mronchka/KeiserMagBridge/bench/diagrams/m3_overview.png

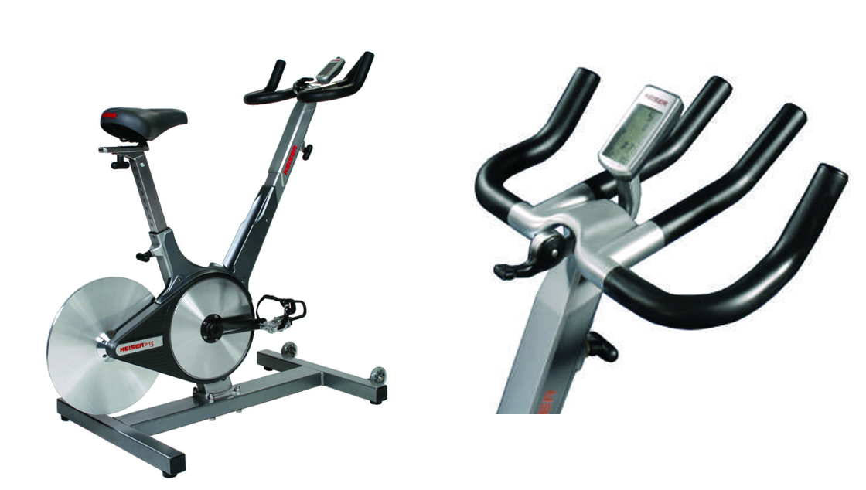
bench/diagrams/m3_overview.png
