mronchka/KeiserMagBridge/bench/diagrams/m3_belt_covers.png

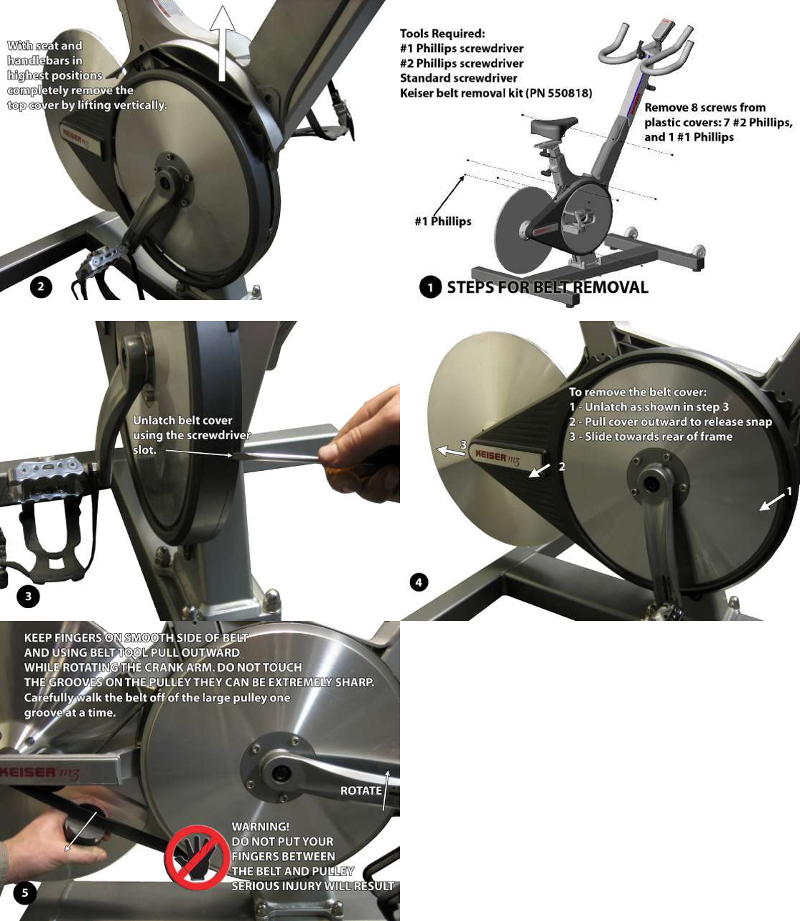
bench/diagrams/m3_belt_covers.png
