mronchka/KeiserMagBridge/bench/diagrams/m3_circuit_board.png

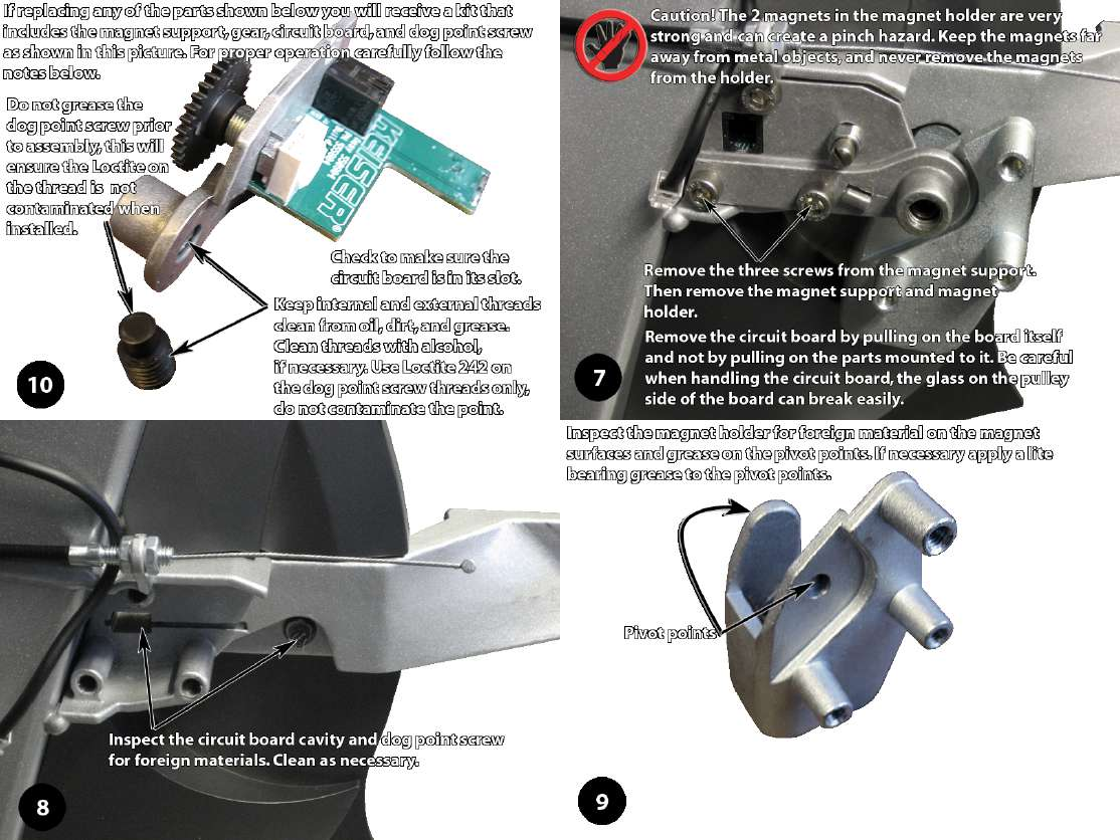
bench/diagrams/m3_circuit_board.png
