mronchka/KeiserMagBridge/bench/diagrams/m3_resistance_mechanism.png

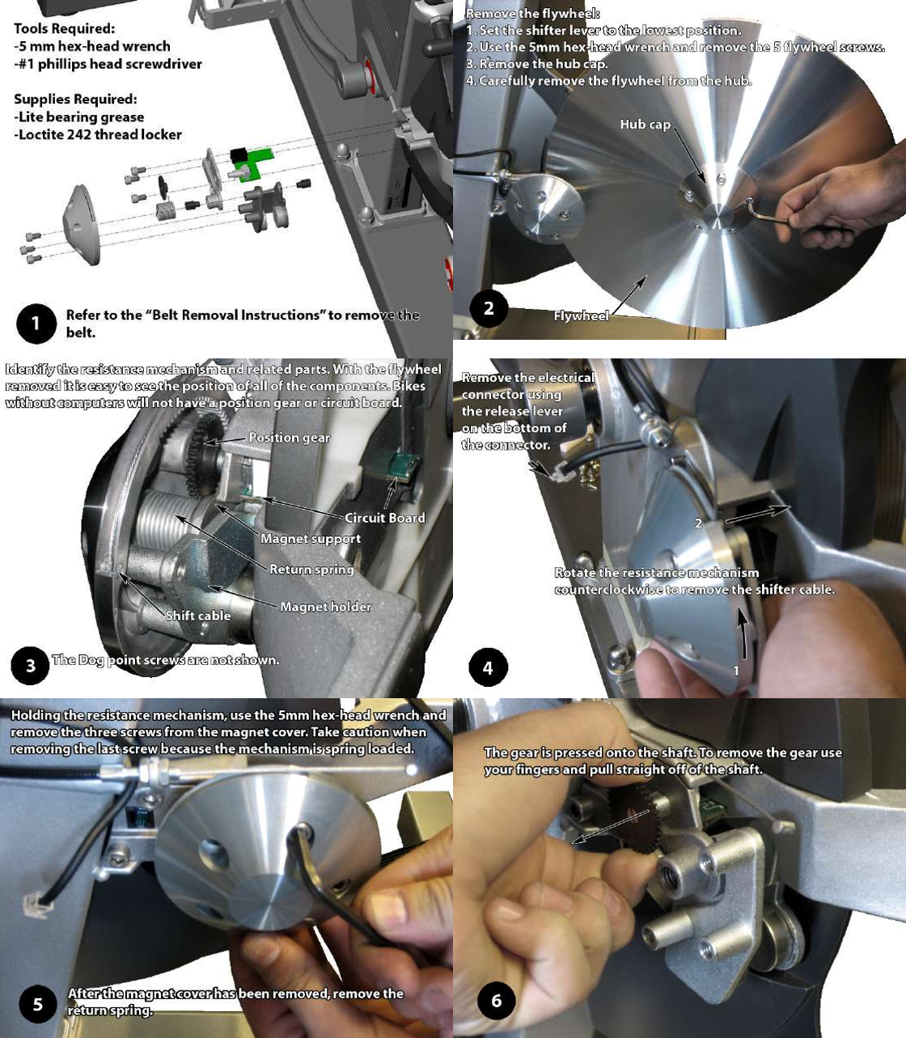
bench/diagrams/m3_resistance_mechanism.png
