mronchka/KeiserMagBridge/bench/results/method_bench_2026-10-15_cadence_test.csv

method | label | condition | sd_ped | p2p_ped | bias_abs_med | bias_abs_max | sd_easy | sd_fast | sd_still | resolution | steps_resolved | steps_total | delay_med | stopped_bias
sketch_now | Sketch v1/v2 smoothing (130 ms) | clean | 13.7015 | 42.8455 | 0.4077 | 1.7890 | 18.1336 | 12.5512 | 0.1466 | 54.8059 | 0 | 10 | nan | -11.4140
sketch_now | Sketch v1/v2 smoothing (130 ms) | stalls | 10.1722 | 35.8780 | 1.2186 | 2.1905 | 15.5400 | 9.5736 | 0.1146 | 40.6887 | 0 | 10 | nan | -11.3719
ema_1s | Plain smoothing | 1 s | clean | 2.7279 | 7.2634 | 0.1818 | 0.4498 | 5.0111 | 2.2877 | 0.0767 | 10.9118 | 3 | 10 | 5.5599 | -11.0223
ema_1s | Plain smoothing | 1 s | stalls | 3.2542 | 10.3956 | 0.5440 | 1.0914 | 5.0923 | 3.0219 | 0.0761 | 13.0169 | 3 | 10 | 6.3399 | -11.0034
ema_2s | Plain smoothing | 2 s | clean | 1.3767 | 3.7537 | 0.3100 | 2.1744 | 2.5598 | 1.1454 | 0.2131 | 5.5068 | 7 | 10 | 5.4539 | -10.3038
ema_2s | Plain smoothing | 2 s | stalls | 1.6851 | 5.1662 | 0.4520 | 2.1189 | 2.6009 | 1.6225 | 0.1788 | 6.7403 | 5 | 10 | 6.2959 | -10.2412
box_2s | Moving average | 2 s | clean | 2.3069 | 6.6042 | 0.1789 | 0.4606 | 3.3218 | 1.6501 | 0.0829 | 9.2275 | 3 | 10 | 5.4989 | -10.9611
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
