mronchka/KeiserMagBridge/bench/logs/2026-10-15_cadence_test_turns.csv

t_epoch_s | lever_uT_turn_avg | rpm
1792114582.470 | -126.38 | 75.1
1792114583.280 | -126.73 | 73.1
1792114584.081 | -126.31 | 76.9
1792114584.850 | -126.30 | 79.1
1792114585.629 | -126.08 | 75.1
1792114586.439 | -126.60 | 73.1
1792114587.229 | -125.21 | 79.1
1792114587.987 | -115.78 | 79.2
1792114588.746 | -105.32 | 79.1
1792114589.494 | -103.80 | 81.3
1792114590.233 | -103.80 | 81.2
1792114590.981 | -104.14 | 79.2
1792114591.750 | -104.53 | 76.9
1792114592.530 | -103.32 | 77.0
1792114593.319 | -103.71 | 75.0
1792114594.130 | -104.30 | 73.1
1792114594.930 | -93.94 | 77.0
1792114595.710 | -91.63 | 76.8
1792114596.490 | -90.75 | 76.9
1792114597.280 | -91.05 | 75.0
1792114598.080 | -80.17 | 75.0
1792114598.890 | -79.30 | 73.2
1792114599.711 | -78.60 | 73.1
1792114600.542 | -78.29 | 71.3
1792114601.393 | -79.02 | 69.7
1792114602.234 | -77.23 | 73.1
1792114603.075 | -76.13 | 69.6
1792114603.916 | -74.81 | 73.3
1792114604.746 | -75.20 | 71.3
1792114605.586 | -74.84 | 71.4
1792114606.407 | -73.65 | 74.9
1792114607.208 | -74.71 | 74.9
1792114608.007 | -74.35 | 75.1
1792114608.807 | -73.47 | 75.0
1792114609.617 | -73.68 | 73.2
1792114610.437 | -73.07 | 73.1
1792114611.268 | -73.98 | 71.3
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
