mronchka/KeiserMagBridge/bench/tests/test_v33_sim.py

"""Tier B (bench/V3_3_PLAN.md section 6): closed-loop simulated riders on fw_model.

Usage: py -3 bench/tests/test_v33_sim.py [--only B1,B3] [--quick] [--save-scenarios]

The riders (riders.py) behave like the real bike on 2026-10-16: the lever
settles back after stopping, sometimes creeps, wobbles turn to turn
(median 0.5 uT between turns), cadence drops from ~75 to ~45 rpm in the high
gears.  Scenarios B1-B12 follow the plan.  On the v3.2 model, scenarios that
need a v3.3 feature are SKIPped with the missing name; checks that the v3.2
model fails here are the v3.2 problems v3.3 is meant to fix (issues #2-#4).

--save-scenarios writes B1, B5 and B12 runs to bench/tests/scenarios/*.json
for hil_replay.py (open-loop replay on the board).
Exit code 1 if a check fails.
"""
import math
import os
import statistics as st
import sys

sys.path.insert(0, os.path.dirname(os.path.abspath(__file__)))
import fw_model as fw  # noqa: E402
import riders as R  # noqa: E402
from riders import API, UP_EDGE  # noqa: E402

HERE = os.path.dirname(os.path.abspath(__file__))
ARGS = sys.argv[1:]
QUICK = "--quick" in ARGS
SAVE = "--save-scenarios" in ARGS
ONLY = None
if "--only" in ARGS:
    ONLY = set(ARGS[ARGS.index("--only") + 1].upper().split(","))
SEEDS = (1,) if QUICK else (1, 2)
ck = R.Checker("test_v33_sim")
V33 = API.is_v33()
print(f"Model: {API.version()} ({'v3.3 API found' if V33 else 'no derive_tolerances: v3.2 model, v3.3-only checks skip'})")


def want(name):
    return ONLY is None or name in ONLY


def need(feature, ok):
    if not ok:
        ck.skip(f"needs the v3.3 model: {feature}")
    return ok


def summary(r):
    e = r.errors()
    eh = max((x["err_hold"] for x in e), default=0)
    return (f"{r.label}: {r.sim.t():.0f} s, {len(r.ups())} up + {len(r.downs())} down, "
            f"in order {r.in_order()}, {r.f_end()} {r.flags() or ''}, N,behind {r.count('N,behind')}, "
            f"go-backs {r.gobacks()} (+{r.gobacks(False) - r.gobacks()} after N,stuck), N,stuck {r.count('N,stuck')}, rider undos {r.rider.undos}, W {r.count('W,')}, P {r.count('P,')}, worst hold error {eh:.2f} uT")


def survey_ok(r):
    z = [l for l in r.lines if l.startswith("Z,")]
    return z


def complete(r, tag, n_down=22):
    ck.check(r.saved() and len(r.ups()) == 24 and len(r.downs()) == n_down,
             f"{tag}: saved, 24 up + {n_down} down points ({len(r.ups())} + {len(r.downs())})")


def accurate(r, tag, lim=None, unit=1.0):
    """lim given: every point within lim (wobble-free riders).  Otherwise the realistic lever's
    statistics: median <= 0.35, 90th percentile <= 0.8, worst <= 1.3 uT (x unit).  A 3-turn average of
    the bike's wobble is off by 0.19 uT typically and 0.91 uT at the 90th percentile (NOTES.md)."""
    e = sorted(x["err_hold"] for x in r.errors())
    if not e:
        return ck.check(False, f"{tag}: no points")
    if lim is not None:
        bad = [(x["key"], round(x["err_hold"], 2)) for x in r.errors() if x["err_hold"] > lim * unit]
        return ck.check(not bad, f"{tag}: every point within {lim * unit:.2f} uT of where the lever rested {bad[:6] if bad else ''}")
    med, p90, mx = e[len(e) // 2], e[int(0.9 * (len(e) - 1))], e[-1]
    ck.check(med <= 0.35 * unit and p90 <= 0.8 * unit and mx <= 1.3 * unit,
             f"{tag}: points vs where the lever rested: median {med:.2f}, p90 {p90:.2f}, worst {mx:.2f} uT "
             f"(limits {0.35 * unit:.2f} / {0.8 * unit:.2f} / {1.3 * unit:.2f})")


def step_len(key):
    """The console step this point is reached by (uT along the lever, scale 1)."""
    i = key if isinstance(key, int) else key[1]
    if isinstance(key, int):
        return UP_EDGE[i] - UP_EDGE[i - 1] if i > 0 else 99.0
    return UP_EDGE[i + 1] - UP_EDGE[i] if i < 23 else 99.0


def early_save(x):
    """Saved well short of where the rider meant to stop (more than 40 % of the step, and 1.5 uT)."""
    return x["err_stop"] is not None and x["err_stop"] > max(1.5, 0.4 * step_len(x["key"]))


def steps_seen(r):
    return getattr(r, "steps", [])


def run(label, **kw):
    """run_cal plus a step-number trace."""
    steps = []
    rk = kw.pop("rider_kw", {}) or {}
    r = R.run_cal(label=label, rider_kw=rk, **kw)
    return r


# ================================================================== B1
if want("B1"):
    print("\nB1. Normal rider at 3 cadences: 46 points in order, accurate, no go-backs, no flags")
    for rpm in (55, 90):
        r = run(f"B1a {rpm} rpm, no wobble", seed=5, rpm=rpm, sim_kw=dict(wobble=0.0))
        print("   " + summary(r))
        complete(r, f"B1a {rpm} rpm")
        accurate(r, f"B1a {rpm} rpm (lever without wobble)", lim=0.6)
        ck.check(r.gobacks() == 0 and r.rider.undos == 0 and r.in_order(), f"B1a {rpm} rpm: in order, no go-back")
    flags_total, runs = 0, 0
    for rpm in (55, 75, 90):
        for seed in SEEDS:
            r = run(f"B1 {rpm} rpm seed {seed}", seed=seed, rpm=rpm, sim_kw=dict(record=SAVE and seed == 1 and rpm == 75))
            print("   " + summary(r))
            tag = f"B1 {rpm} rpm s{seed}"
            complete(r, tag)
            ck.check(r.in_order(), f"{tag}: both passes in lever order")
            accurate(r, tag)
            ck.check(r.gobacks() == 0 and r.rider.undos == 0, f"{tag}: no false go-back, never stuck (go-backs {r.gobacks()}, undos {r.rider.undos})")
            ck.check(r.count("P,") == 0, f"{tag}: no 'keeps changing' card")
            flags_total += len(r.flags())
            runs += 1
            if V33:
                z = survey_ok(r)
                ck.check(bool(z) and z[-1].split(",")[-1] == "ok", f"{tag}: survey ran, verdict ok ({z[-1] if z else 'no Z'})")
            if SAVE and seed == 1 and rpm == 75:
                R.save_scenario(r.sim.scenario("B1", "normal rider 75 rpm seed 1"), os.path.join(HERE, "scenarios", "B1.json"))
                print("   saved scenarios/B1.json")
    ck.check(flags_total / runs <= 0.2, f"B1: false flags per clean calibration {flags_total}/{runs} = {flags_total / runs:.2f} (<= 0.2)")

# ================================================================== B2
if want("B2"):
    print("\nB2. Slow shifter: 2.5 s before each move; nothing saved before the lever moved")
    for seed in SEEDS:
        r = run(f"B2 seed {seed}", seed=seed + 10, rider_kw=dict(react_s=2.5))
        print("   " + summary(r))
        early = [(x["key"], round(x["err_stop"], 1)) for x in r.errors() if early_save(x)]
        ck.check(not early, f"B2 s{seed}: no point saved before the lever got there {early[:6] if early else ''}")
        complete(r, f"B2 s{seed}")
        ck.check(r.gobacks() == 0 and r.rider.undos == 0,
                 f"B2 s{seed}: no false go-back (the lever settles while the rider waits; go-backs {r.gobacks()}, undos {r.rider.undos})")

# ================================================================== B3
if want("B3"):
    print("\nB3. Stop - shift - pedal at every gear (3-8 s stops): completes, no 'keeps changing', no buzzer")
    for seed in SEEDS:
        r = run(f"B3 seed {seed}", seed=seed + 20, rider_kw=dict(stop_shift=1.0, pause_s=(3.0, 8.0)), seconds=1500)
        print("   " + summary(r))
        complete(r, f"B3 s{seed}")
        ck.check(r.count("P,") == 0, f"B3 s{seed}: never the 'keeps changing' card (P lines: {r.count('P,')})")
        accurate(r, f"B3 s{seed}")
        beeps = getattr(r.f, "beeps", None)
        if beeps is not None:
            ck.check(not [b for b in beeps if b[1] in ("buzz", "warn", "alarm")], f"B3 s{seed}: no buzzer")
        else:
            ck.skip("B3: buzzer check needs Firmware.beeps (speaker events) in the model")

# ================================================================== B4
if want("B4"):
    print("\nB4. A 60 s rest in the up pass (point 12) and the down pass (down point 10): resumes, nothing lost")
    for seed in SEEDS:
        r = run(f"B4 seed {seed}", seed=seed + 30,
                rider_kw=dict(rests={(fw.PASS_UP, 11): 60.0, (fw.PASS_DOWN, 9): 60.0}), seconds=1500)
        print("   " + summary(r))
        complete(r, f"B4 s{seed}")
        # v3.4: no N,stuck hint, so in auto mode a gear that sits on the one before (here down 4 / 5, 0.5 uT
        # apart) can leave the rider waiting until they undo; press mode (test_v34_press.py) has none.
        ck.check(r.gobacks() == 0 and r.rider.undos <= 2 and r.count("A,") == 0,
                 f"B4 s{seed}: no go-back / abort around the rests, at most 2 undos ({r.gobacks()}, {r.rider.undos}, {r.count('A,')})")
        keys = [c[1] for c in r.f.captures]
        redone = {int(l.split(",")[1]) for l in r.lines if l.startswith("U,")}       # went back to it (U,<step>)
        twice = sorted({str(k) for k in keys if keys.count(k) > 1 and (k if isinstance(k, int) else k[1]) not in redone})
        ck.check(not twice, f"B4 s{seed}: no point captured twice without a go-back/undo {twice}")
        accurate(r, f"B4 s{seed}")
        ck.check(r.count("P,") == 0, f"B4 s{seed}: no 'keeps changing' card after the rest")

# ================================================================== B5
if want("B5"):
    print("\nB5. Overshoot on the up pass (point 10) and the down pass (down point 13): one go-back, redone at the edge")
    for ps, step, name in ((fw.PASS_UP, 9, "up point 10"), (fw.PASS_DOWN, 12, "down point 13")):
        r = run(f"B5 {name}", seed=41, rider_kw=dict(overshoot_at={(ps, step)}),
                sim_kw=dict(record=SAVE and ps == fw.PASS_UP))
        print("   " + summary(r))
        lc = r.last_caps()
        key = ('u', step) if ps == fw.PASS_UP else ('d', step)
        want_ = r.sim.stops.get((ps, step), float("nan"))             # where the rider came back to
        got = R.along(lc[key][1]) if key in lc else float("nan")
        ck.check(r.gobacks() == 1 and r.rider.undos == 0, f"B5 {name}: the board went back once by itself ({r.gobacks()}, undos {r.rider.undos})")
        ck.check(abs(got - want_) < 1.0 and r.in_order(), f"B5 {name}: redone where the rider came back to the edge "
                                                          f"({got:.1f} vs {want_:.1f}, within 1.0), in order")
        complete(r, f"B5 {name}")
        if SAVE and ps == fw.PASS_UP:
            R.save_scenario(r.sim.scenario("B5", "overshoot at up point 10, seed 41"), os.path.join(HERE, "scenarios", "B5.json"))
            print("   saved scenarios/B5.json")

    print("   B5b: a small overshoot (1.2 uT past the next edge, under the behind tolerance)")
    for ps, step, name in ((fw.PASS_UP, 9, "up point 10"), (fw.PASS_DOWN, 12, "down point 13")):
        r = run(f"B5b {name}", seed=42, rider_kw=dict(overshoot_at={(ps, step)}, overshoot_by=1.2))
        print("   " + summary(r))
        complete(r, f"B5b {name}")
        # the rider then stands at the next point, which is within must-move of the overshot one
        quiet = [x for x in r.rider.log if "undo" in x[1]]
        # v3.4: the N,stuck hint is gone (it misled the rider on the bike); a wait can end in one undo
        ck.check(len(quiet) <= 1, f"B5b {name}: at most one undo after the small overshoot (undos: {quiet[:2]})")
        flagged_ = {(p, n) for p, n, _ in r.flags()}
        ck.info(f"B5b {name}: go-backs {r.gobacks()}, N lines {r.count('N,')}, final flags {sorted(flagged_)}")

# ================================================================== B6
if want("B6"):
    print("\nB6. The lever settles back 0.1-0.8 uT (sometimes 1.2) after every save (the v3.2b behaviour): no go-backs")
    for seed in SEEDS:
        r = run(f"B6 seed {seed}", seed=seed + 60, sim_kw=dict(settle=(1.0, "save"), settle_big=0.15))
        print("   " + summary(r))
        ck.check(r.gobacks() == 0 and r.rider.undos == 0,
                 f"B6 s{seed}: zero go-backs (go-backs {r.gobacks()}, undos {r.rider.undos})")
        complete(r, f"B6 s{seed}")
        ck.check(len(r.flags()) <= 1, f"B6 s{seed}: at most 1 flag ({r.flags()})")

# ================================================================== B7
if want("B7"):
    print("\nB7. Pauses mid-gear (still pedalling) with a stored calibration at the same spot")
    for frac, hard in (((0.2, 0.35), True), ((0.45, 0.6), False)):
        for seed in SEEDS:
            cal = R.scaled_cal_at()
            r = run(f"B7 frac {frac} seed {seed}", seed=seed + 70, cal=cal,
                    rider_kw=dict(mid_pause=1.0, mid_s=(4.0, 6.0), mid_frac=frac), seconds=1500)
            print("   " + summary(r))
            mids = r.rider.mids
            saved_mid = []
            for x in r.errors():
                k = x["key"]
                sk = (fw.PASS_UP, k) if isinstance(k, int) else ((fw.PASS_DOWN, k[1]) if k[0] == 'd' else None)
                if sk in mids and abs(x["at"] - mids[sk][0]) < 1.0 and early_save(x):
                    saved_mid.append(sk)
            nm = lambda k: ("u" if k[0] == fw.PASS_UP else "d") + str(k[1] + 1)  # noqa: E731
            msg = (f"B7 pauses at {frac[0]:.2f}-{frac[1]:.2f} of the step, s{seed}: none saved mid-gear "
                   f"({len(saved_mid)} of {len(mids)} were: {' '.join(nm(k) for k in saved_mid[:12])})")
            if hard:
                ck.check(len(saved_mid) <= 10, msg + " (known limit: pass at <= 10)")
            else:
                ck.info(msg + " [spec: must-move = 0.4 x expected step, so pauses past 0.4 can't be told apart]")
            complete(r, f"B7 {frac} s{seed}")

# ================================================================== B8
if want("B8"):
    print("\nB8. Phone disconnect during the up pass (point 8, 20 s)")
    f0 = fw.Firmware()
    if need("Firmware.phone_connected()", hasattr(f0, "phone_connected")):
        for src, should_pause in (("ble", True), ("usb", False)):
            r = R.run_cal(label=f"B8 from {src}", seed=81, start=src,
                          rider_kw=dict(disconnects={(fw.PASS_UP, 7): 20.0}), sim_kw=dict(record=SAVE and src == "ble"))
            if SAVE and src == "ble":
                R.save_scenario(r.sim.scenario("B8_phone_drop", "phone (BLE) calibration, phone away 20 s at up point 8"),
                                os.path.join(HERE, "scenarios", "B8_phone_drop.json"))
                print("   saved scenarios/B8_phone_drop.json (model-only: BLE)")
            print("   " + summary(r))
            offs = [t for t, w in r.rider.log if w.startswith("phone off")]
            ons = [t for t, w in r.rider.log if w == "phone on"]
            if offs and ons:
                t0, t1 = offs[0] * 1000, ons[0] * 1000
                during = [c for c in r.f.captures if t0 < c[0] < t1]
                pz = [(t, l) for t, l in r.f.out if l.startswith(("Paused", "Resumed"))]
                if should_pause:
                    ck.check(any("phone" in l for _, l in pz), f"B8 {src}: 'Paused: phone disconnected' ({pz[:2]})")
                if should_pause:
                    ck.check(not during, f"B8 {src}: nothing saved while the phone was away ({len(during)})")
                else:
                    ck.check(True, f"B8 {src}: calibration started from USB keeps going ({len(during)} saved meanwhile)")
            complete(r, f"B8 {src}")

# ================================================================== B9
if want("B9"):
    print("\nB9. Field strength x0.3 and x3 (board further / closer): tolerances scale, B1 still passes")
    tols = {}
    for scale in (1.0, 0.3, 3.0):
        r = run(f"B9 x{scale}", seed=91, sim_kw=dict(scale=scale), seconds=1200)
        print("   " + summary(r))
        tag = f"B9 x{scale}"
        complete(r, tag)
        ck.check(r.in_order(), f"{tag}: in order")
        e = r.errors()
        if scale >= 0.5:
            accurate(r, tag + " (lever uT; limits x 1/scale: same uT of field)", unit=max(1.0, 1.0 / scale))
        else:   # known limit: at x0.3 the sensor's own noise is ~1/3 of a gear here; the placement check calls it "weak"
            e = sorted(x["err_hold"] for x in r.errors()) or [0.0]
            print(f"   (known limit) {tag} accuracy, lever uT: median {e[len(e) // 2]:.2f}, worst {e[-1]:.2f}")
        ck.check(r.gobacks() == 0 and r.rider.undos == 0, f"{tag}: no false go-back, never stuck (go-backs {r.gobacks()}, undos {r.rider.undos})")
        if scale >= 0.5:
            ck.check(len(r.flags()) <= 1, f"{tag}: at most 1 flag ({r.flags()})")
        else:   # known limit (see accuracy above): weak signal, edges blur
            print(f"   (known limit) {tag} flags: {r.flags()}")
        tols[scale] = API.tol(r.f)
    if V33 and all(tols.values()):
        for key in ("behind", "move", "agree"):
            if all(key in t for t in tols.values()):
                ratio = tols[3.0][key] / tols[1.0][key]
                ck.check(1.5 <= ratio <= 4.0, f"B9: tolerance '{key}' at x3 / x1 = {ratio:.2f} (scales up)")
    else:
        ck.skip("B9: tolerance scaling needs Firmware.tol")
    f0 = fw.Firmware()
    if need("placement stream: command('v') -> X lines", V33):
        xs = {}
        for scale in (1.0, 3.0):
            f = fw.Firmware()
            sim = R.Sim(f, seed=92, scale=scale)
            sim.run(2)
            f.command('v')
            sim.move_to(R.PEDAL_TOP, 20.0)
            sim.run(10)
            X = [l for _, l in f.out if l.startswith("X,")]
            xs[scale] = [float(v) for v in X[-1].split(",")[1:6]] if X else None
        if xs[1.0] and xs[3.0]:
            ck.check(2.0 <= xs[3.0][1] / max(xs[1.0][1], 1e-6) <= 4.0,
                     f"B9: placement swing x3 / x1 = {xs[3.0][1] / max(xs[1.0][1], 1e-6):.2f}")
            ck.check(xs[3.0][3] < xs[1.0][3], f"B9: headroom drops when closer ({xs[1.0][3]:.0f} -> {xs[3.0][3]:.0f} %)")
        else:
            ck.check(False, "B9: X lines after 'v'")

# ================================================================== B10
if want("B10"):
    print("\nB10. First-ever calibration, and a board that moved since the stored one")
    if need("survey Z line", V33):
        cases = (("first", None), ("new", R.scaled_cal_at(scale=0.8, shift=[6.0, -4.0, 5.0])),
                 ("same", R.scaled_cal_at()))
        for spot, cal in cases:
            r = run(f"B10 {spot}", seed=101, cal=cal)
            print("   " + summary(r))
            z = survey_ok(r)
            got = z[-1].split(",")[3] if z else None
            ck.check(got == spot, f"B10 {spot}: Z says spot={got}")
            complete(r, f"B10 {spot}")
            ck.check(r.gobacks() == 0 and r.rider.undos == 0, f"B10 {spot}: no go-backs")

# ================================================================== B11
if want("B11"):
    print("\nB11. Fast 10-gear flicks after a calibration: how long until the gear shows right (not pass/fail)")
    r = run("B11 base", seed=111)
    cal = R.copy_cal(r.f.cal)
    g = fw.Firmware(cal=cal)
    g.crank["ok"] = True
    sim = R.Sim(g, seed=112, h=r.sim.h, settle=None, creep_p=0.0)
    times = []
    for a, b in ((1, 11), (11, 1), (3, 13), (13, 3), (8, 18), (18, 8)):
        sim.move_to(0.5 * (UP_EDGE[a - 1] + UP_EDGE[a]), 30.0)
        sim.run(6)
        tgt = 0.5 * (UP_EDGE[b - 1] + UP_EDGE[b])
        sim.move_to(tgt, 40.0)                       # ~1.5 s for 10 gears
        t0 = sim.t() + abs(tgt - sim.L) / 40.0
        ok_at = None
        end = sim.t() + 12
        while sim.t() < end:
            sim.step()
            if sim.t() >= t0 and g.stableGear == sim.console.g:
                if ok_at is None:
                    ok_at = sim.t()
            elif sim.t() >= t0:
                ok_at = None
        times.append((a, b, (ok_at - t0) if ok_at else None))
    ck.info("resync after a flick (s): " + ", ".join(f"{a}->{b}: {t:.1f}" if t is not None else f"{a}->{b}: never"
                                                      for a, b, t in times))

# ================================================================== B12
if want("B12"):
    print("\nB12. Stop the down pass halfway ('s', 'x', power loss), then #D later")
    for how in ("s", "x", "power"):
        f = fw.Firmware()
        sim = R.Sim(f, seed=121, record=SAVE and how == "x")
        rider = R.Rider(sim)
        stop_at = 12

        def pol(s, how=how):
            rider(s)
            if s.f.calPass == fw.PASS_DOWN and s.f.calStep == stop_at - 1 and s.f.calState == fw.CAL_WAITING:
                if how in ("s", "x"):
                    s.cmd(how)
                return True
            return s.f.calState == fw.CAL_IDLE and rider.done
        sim.run(2)
        if sim.record:
            sim.trace.append(("c", f.ms_now, ('c', 'usb')))
        API.start(f)
        sim.run(900, pol)
        if how == "power":
            g = fw.Firmware(cal=R.copy_cal(f.cal) if f.cal else None)
        else:
            g = f
        mask = (g.cal or {}).get("downMask", 0) if g.calValid else 0
        n = bin(mask).count("1")
        want_n = fw.DOWN_FIRST - stop_at + 1           # down points 23..stop_at+1 captured
        tag = f"B12 '{how}'"
        if how == "s":
            ck.check(n == want_n, f"{tag}: the {want_n} down points so far are kept ({n})")
        elif need(f"{tag}: partial down pass committed on '{how}'", V33):
            ck.check(n == want_n, f"{tag}: the {want_n} down points so far are kept ({n})")
        if need("#D (resume the down pass)", V33):
            if how == "power":
                sim.f = g
            kept = {i: list(g.cal["down"][i]) for i in range(1, fw.DOWN_FIRST + 1) if (mask >> i) & 1}
            sim.run(20)                                  # later...
            sim.hash_line("D")
            ck.check(g.calPass == fw.PASS_DOWN and g.calStep == stop_at - 1,
                     f"{tag} then #D: resumes at down point {stop_at} (at {g.calStep + 1})")
            rider2 = R.Rider(sim)
            sim.run(600, rider2)
            mask = g.cal.get("downMask", 0)
            ck.check(bin(mask).count("1") == fw.DOWN_FIRST, f"{tag} then #D: the down pass finished (mask {bin(mask).count('1')})")
            moved = [i + 1 for i, v in kept.items() if fw.dist3(v, g.cal["down"][i]) > 1e-6]
            ck.check(not moved, f"{tag} then #D: the kept down points are unchanged {moved}")
            ck.check(g.cal["pts"] == f.cal["pts"] if how != "power" else True, f"{tag} then #D: up points unchanged")
            if SAVE and how == "x":
                R.save_scenario(sim.scenario("B12", "down pass stopped with x at down point 12, then #D"),
                                os.path.join(HERE, "scenarios", "B12.json"))
                print("   saved scenarios/B12.json")


# ================================================================== review additions (B10b, B9b, B12b, B7b)
def longest_point(r):
    """Longest time (s) from a point's prompt to its capture (or the next prompt), and which point."""
    out = r.f.out
    worst, which = 0.0, None
    for j, (t, l) in enumerate(out):
        if not (l.startswith("[UP point") or l.startswith("[DOWN point")):
            continue
        t_end = None
        for t2, l2 in out[j + 1:]:
            if l2.startswith(("C,", "U,", "[UP point", "[DOWN point", "A,", "K,")):
                t_end = t2
                break
        t_end = t_end if t_end is not None else r.f.ms_now
        if (t_end - t) / 1000.0 > worst:
            worst, which = (t_end - t) / 1000.0, l.split("]")[0][1:]
    return worst, which


if want("B10B"):
    print("\nB10b. A new spot whose gear spacing isn't the profile's (first-ever calibration)")
    mean_step = sum(R.STEPS) / len(R.STEPS)
    profiles = (("low gears 4 uT", [4.0, 4.0, 4.0] + R.STEPS[3:]), ("reversed", R.STEPS[::-1]),
                ("uniform x0.5", [0.5 * mean_step] * len(R.STEPS)))
    for label, steps in profiles:
        for seed in SEEDS:
            r = run(f"B10b {label} s{seed}", seed=130 + seed, sim_kw=dict(steps=steps))
            print("   " + summary(r))
            tag = f"B10b {label} s{seed}"
            ck.check(r.saved() and len(r.ups()) == 24 and len(r.downs()) == 22,
                     f"{tag}: completes ({len(r.ups())} up + {len(r.downs())} down)")
            ck.check(r.rider.undos <= 1, f"{tag}: at most 1 undo ({r.rider.undos})")
            w, which = longest_point(r)
            # v3.4: without the N,stuck hint a point the auto rule can't see the rider reach waits for the
            # rider's undo (45 s here); press mode keeps the 30 s limit (test_v34_press.py P9)
            ck.check(w <= 50.0, f"{tag}: no point stuck over 50 s (longest {w:.0f} s at {which})")

if want("B9B"):
    print("\nB9b. Field x0.3 / x0.5 with the sensor noise at today's level (not scaled)")
    for scale in (0.3, 0.5):
        for seed in SEEDS:
            r = run(f"B9b x{scale} s{seed}", seed=140 + seed, sim_kw=dict(scale=scale, noise_scales=False),
                    seconds=1500)
            print("   " + summary(r))
            tag = f"B9b x{scale} s{seed}"
            rej = [l for l in r.lines if l.startswith("K,0") and ("are the same" in l or "folds back" in l)]
            ck.check(not rej, f"{tag}: the up pass isn't rejected {rej[:1]}")
            efail = [l for l in r.lines if l.startswith("E,fail")]
            ck.check(not efail, f"{tag}: the down-pass save never ends in E,fail {efail[:2]}")
            ck.check(r.saved(), f"{tag}: saved ({[l for l in r.lines if l.startswith('K,')][-1:]})")

if want("B12B"):
    print("\nB12b. #D resume: no 'shift up first' after the first down capture; an overshoot still goes back")
    if need("#D", V33):
        for seed in SEEDS:
            half = R.scaled_cal_at()
            half["downMask"] = sum(1 << i for i in range(12, fw.DOWN_FIRST + 1))   # down points 23..13 kept
            f = fw.Firmware(cal=half)
            sim = R.Sim(f, seed=150 + seed)
            sim.run(3)
            sim.move_to(R.UP_EDGE[13])                     # the rider comes back somewhere in gear 14
            sim.run(5)
            sim.hash_line("D")
            ck.check(f.calPass == fw.PASS_DOWN and f.calStep == 11 and "B" in API.flags(f),
                     f"B12b s{seed}: #D resumes at down point 12 and asks to shift up first (B: {API.flags(f)})")
            rider = R.Rider(sim, overshoot_at={(fw.PASS_DOWN, 9)})
            seen = {}

            def pol(s, seen=seen, f=f):
                if f.calState == fw.CAL_WAITING and f.calPass == fw.PASS_DOWN and f.calStep == 10 \
                        and "first" not in seen:
                    seen["first"] = API.flags(f)                # right after the first resumed capture
                return rider(s)
            n0 = len(f.out)
            sim.run(600, pol)
            ck.check("first" in seen and "B" not in seen["first"],
                     f"B12b s{seed}: after the first resumed capture no 'First shift UP' (flag B / downGate: "
                     f"{seen.get('first')})")
            after = f.out[n0:]
            gb = sum(1 for (t0, a), (t1, b) in zip(after, after[1:]) if a == "N,behind" and b.startswith("U,")
                     and b.endswith(",d") and t0 == t1)
            ck.check(gb >= 1, f"B12b s{seed}: an overshoot at down point 10 in the resumed pass goes back by itself "
                              f"(go-backs {gb}, N lines {[l for _, l in after if l.startswith('N,')][:4]})")
            ck.check(bin(f.cal["downMask"]).count("1") == fw.DOWN_FIRST,
                     f"B12b s{seed}: the resumed down pass finishes ({bin(f.cal['downMask']).count('1')} of 22)")

if want("B7B"):
    print("\nB7b. No N,stuck during mid-gear pauses more than 0.5 x step from the previous point")
    if need("N,stuck", V33):
        for seed in SEEDS:
            r = run(f"B7b seed {seed}", seed=160 + seed, cal=R.scaled_cal_at(),
                    rider_kw=dict(mid_pause=1.0, mid_s=(6.0, 9.0), mid_frac=(0.55, 0.7)), seconds=1500)
            print("   " + summary(r))
            E = r.sim.edges
            bad = []
            caps = [(ms, k, R.along(p)) for ms, k, p in r.f.captures]
            for t, l in r.f.out:
                if l != "N,stuck":
                    continue
                lev = r.sim.lever_at(t)
                prev = [c for c in caps if c[0] < t]
                if not prev:
                    continue
                ms_p, k_p, at_p = prev[-1]
                i = (k_p + 1) if isinstance(k_p, int) else (k_p[1] - 1)       # the point being measured
                if not 1 <= i <= 23:
                    continue
                step = (E[i] - E[i - 1]) if isinstance(k_p, int) else (E[i + 1] - E[i])
                ps = fw.PASS_UP if isinstance(k_p, int) else fw.PASS_DOWN
                stop = r.sim.stops.get((ps, i))
                # the board judges from the point it saved, on noisy turns: only clear cases (> 0.75 x step) count
                if abs(lev - at_p) > 0.75 * step and stop is not None and abs(lev - stop) > 1.0:
                    bad.append((("u" if ps == fw.PASS_UP else "d") + str(i + 1), round(abs(lev - at_p) / step, 2)))
            # Advisory (lead decision 2026-10-16): the hint is conditional ("if the console already shows
            # gear N"), and the board judges against the stored spacing, so borderline sends are tolerated.
            ck.check(len(bad) <= 4, f"B7b s{seed}: N,stuck during mid-gear pauses > 0.75 x step from the previous point (advisory, <= 4): "
                              f"{len(bad)} {bad[:6]} (of {r.count('N,stuck')} N,stuck)")

ck.finish()
