mronchka/KeiserMagBridge/(commit log)

2026-10-16 Initial import of Keiser M3 bridge project
    Firmware (v1 to v3.1), phone web app, bench loggers and analysis,
    raw test logs, and the findings dashboard.
    [2026-10-15_cadence_test_turns.csv, method_bench_2026-10-15_cadence_test.csv, method_bench_2026-10-15_cadence_test_steps.csv]
2026-10-16 Turn-based crank learning, cadence check, and calibration redesign
    Firmware (KeiserMagBridge_v3_1, not yet uploaded):
    - Crank learning re-learns every 0.5 s from the buffered samples and ends
    once 6 turns are regular (75% within 0.75-1.33x the median, under
    160 rpm), or after 15 s. Turns seen and the provisional rpm go in the
    status line (new 13th S field, lturns).
    - New cal state 4: after learning the board waits for the rider to confirm
    the rpm matches the console ('n' / button A) or to learn again ('l').
    An L line reports the learning result.
    - Manual captures get the same "lever moved >= 1 uT" check as auto-capture;
    an N line says why a capture was refused.
    bench/replay_lear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
    [replay_learn.py]
2026-10-16 Add the Keiser M3 Bridge product page
    A one-page product site with a 3D model of the bike showing the crank and
    gear magnets' fields in place, a live mock of the app's Ride screen, view
    buttons, cadence and gear sliders, and a calibration section. Power and
    resistance use the same Keiser model as the firmware.
    Source is in product/ (template, field data from bench/export_3d.py, and
    build.py). The built page goes to webapp/product/, so the Pages workflow
    publishes it at /KeiserMagBridge/product/ beside the phone page.
    Also removes webapp/_preview_3d.html, an old preview of this page that was
    committed by mistake.
2026-10-16 v3.1: sensor task, 20-byte BLE pieces, hold-the-lever-still calibration
    - Firmware: sample the magnetometer in its own FreeRTOS task with a
    timestamped queue so Bluetooth sends no longer stall readings.
    - Send long lines over BLE UART in 20-byte pieces (they were cut at 23).
    - While calibrating, if the turn after 3 agreeing turns shows the lever
    still moving, drop the capture, ask the rider to hold still (W line,
    M flag) and retry; after 15 s, offer redo or capture anyway (P line,
    cal state 5).
    - Phone page: hold-still strip, "reading keeps changing" card with
    Redo / Capture anyway, redo reminder, contrast fixes, new demo options.
    - Python model of the sketch with log, stress and B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
    [fw_model.py, replay_learn.py, test_ble_lines.py, test_fw_log.py, test_fw_stress.py]
2026-10-16 v3.2: down pass, faster capture, automatic redo, stronger check
    Firmware (KeiserMagBridge_v3_2):
    - Capture on 2 agreeing turns plus a check turn (3-turn average).
    - Forward-only capture; an overshot point is redone automatically
    (N,behind + U, flag B until the rider has gone back).
    - Point 25 worked out from 23/24 instead of pedalling into the brake.
    - Down pass (points 23..2) for the console's stickiness at each edge.
    - Gear switch points from bias-corrected edges (riders stop ~0.25 uT
    past the change); the path runs through up/down midpoints.
    - Post-calibration check: greedy one-suspect-at-a-time scoring
    (shape, off-path, up/down pair, order) plus the previous calibration
    as a prio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
    [fw_model.py, synth.py, test_fw_log.py, test_fw_v32.py]
2026-10-16 v3.2 bike fixes, the day's bike logs, and the v3.3 plan
    - Firmware (as flashed and used for the full up+down run):
    - behindNow was left set from the previous calibration and blocked
    point 1 of the next one; it is now cleared on every check.
    - Going back no longer cascades: once per point, and after going back
    a point counts only once the reading has come back up 1 uT from its
    lowest (a pause in the gear below was being saved as the point).
    - Logs: 2026-10-16 v3.1 calibration and ride, the two aborted v3.2
    attempts, and the full v3.2 up+down run (50 Hz raw + per-turn).
    - Backups of the v3.2 firmware, model and app as of this run.
    - bench/V3_3_PLAN.md: every open issue, the v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
2026-10-16 v3.3: measured tolerances, survey, checkpoints, pause, new tests
    Firmware (KeiserMagBridge_v3_3, not yet flashed):
    - Survey before the points: noise from still turns, a slow sweep up and
    down, move detection against the stored path (first/same/new spot).
    - Tolerances worked out from measured noise, gear spacing and lever
    settle instead of fixed uT values; at today's spot they reproduce the
    tuned values, and the go-back trigger rises from 0.5 to ~2.2 uT.
    - One flow of numbered steps: the up pass is saved at once, the down
    pass can resume later (#D) and each down point is saved as taken
    (atomic temp-file saves); x keeps what is saved.
    - Pause when pedalling stops or the phone drops: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
    [fw_model.py, hil_replay.py, riders.py, run_all.py, test_fw_log.py, test_fw_stress.py, test_fw_v32.py, test_v33_app.py]
2026-10-17 v3.3 bench: #E erase, board-run sync, batch runner, end-of-run wait
    - #E (USB only, idle) erases the calibration so first-ever scenarios can run on the board
    - hil_replay: '#J,sync' every 4 samples; after the last sample wait up to 20 s
    (the final saves and the check take 5 s or more on the board)
    - hil_board_all: runs B1, B5, B12 and the v3.2b ride, each from an erased board
    - backup of the board's v3.2 calibration before v3.3
2026-10-17 v3.3: 5 s sample queue (flash saves take up to 2.6 s), injection ignores sensor drops
    - SAMPLE_QUEUE_LEN 128 -> 256: a save after each down capture took 1.7-2.6 s on the board,
    overflowing the 2.5 s queue and costing a pedal turn
    - while injecting ('#I'), the real sensor's dropped readings no longer reset turn timing
    - '#S' idle timer counts from the end of processing, so a slow save doesn't end injection
    - board-in-the-loop: B1, B5, B12 and the v3.2b ride all match the model (bench/logs/hil/)
2026-10-17 App: wireframe look and a focused calibration screen that fits an iPhone 16
    - pill buttons (white main action, blue text for the second choice), Apple type sizes,
    20 px margins, a thin cadence line with the rpm dot riding on it
    - while calibrating: no tab bar, a (x) Calibrate Undo top bar; auto-capture and the
    points list stay on the idle Calibrate screen
    - every step fits 393x660 without scrolling: the circle and the step-1 gauge size to the
    screen and give up room for banners, the iPhone lock tip and the down-pass link
    - backup of the page before the restyle
2026-10-17 App step 6: ask only at the wanted gear, cadence line; follow the board into Calibrate
    - gear check: the question waits until the bridge's gear is within 2 of the wanted gear and
    steady for 3 s while pedalling ('faster': pace up 8 rpm); any steady gear after 20 s;
    the answer is the gear that was asked about
    - step 6 shows the rpm line with the pace that check wants
    - demo: the simulated rider shifts toward the wanted gear and holds it during step 6
    - the page switches to Calibrate whenever the board starts calibrating (button, #D, reconnect)
    - tests: gearcheck_v33.js (step 6 in Bluetooth mode), focused-screen checks on the model feeds;
    hil_record_page.py records the board's status line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
2026-10-17 App refactor 3/4: split the script into one file per area
    state, ui, protocol, ble, flow, gearcheck, storage, diag, render/{ride,calibrate,diagnose,console}
    and main (wiring and boot, loaded last). Code moved as is (same functions, same order within each
    area); index.html's loader lists the files. README: a Files section and the release rule
    (bump APP_BUILD and the stylesheet's ?v=).
2026-10-17 App fixes (review round 1): Bluetooth link, saved runs, gear check
    Bluetooth: a connect that never answers times out after 20 s; writes queued on an earlier link
    are dropped instead of going out on the next one; a failed reconnect lets the next tap open the
    chooser; late notifications after a drop are ignored; one wake lock at a time, released if the
    link dropped while it was requested; the placement stream ('v' toggles it, and the board keeps
    it across a drop) is reconciled from the first status line after reconnecting.
    Saved runs: no 'incomplete' copy of a calibration that was already saved (checkpoint, down pass,
    redo, reconnect at the checkpoint); storage-full paths remove the oldest run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
2026-10-17 First v3.3 bike calibration log, and a replay of it through the page
2026-10-17 App fixes (review round 1): protocol, calibration flow, layout; regression tests
    Protocol: E,ok,redo / E,ok,down are the bridge accepting #R / #D (the firmware sends them at the
    start), not 'saved'; K,1 'save failed' and E,ok,save failed say the flash write failed; pod
    cadence (src W) counts as pedalling; C / Q lines need their exact field count and finite numbers
    (a line glued to the next is dropped), and a readback missing a point isn't saved; up to 23
    status fields is a newer bridge.
    Flow: the hold-still method (crank not found) has no checkpoint; #D after Later clears the paused
    redos and lets step 6 run again; no Undo at the first point of a #D down pass; one answer per
    checkpoint; Star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
2026-10-17 App fixes (tester B): reconnects, lost lines, checkpoint stall
    - After a drop, C / E / K lines that come before the first status line still belong to the run
    that was going on (a redo's capture no longer wipes the other points and the down pass), and a
    redo the bridge already started is kept across the drop.
    - A down point lost on the way makes the page read the calibration back, as a lost up point did.
    - One stray idle status line mid-run no longer saves an 'incomplete' copy.
    - A clean 14-field line seen first no longer locks out v3.3 status lines.
    - At the Saved checkpoint a silent link shows 'Waiting for the bridge...' on Continue down.
    - review_fixes.js: 6 more checks.
    Co-Authored-B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
2026-10-17 App fixes (tester A): Ride and Diagnose fit, walkthrough, stopping the down pass
    - Ride, not calibrated: the ring makes room for 'Go to Calibrate' so the tiles stay above the tab bar.
    - Diagnose run: a smaller countdown, and room for 3 lines of step text, so CANCEL fits on every
    step and BACK / NEXT stay in the same place.
    - Before a bridge is connected (or right after a drop) the walkthrough describes pedalling, not
    the old v2 stop-and-hold method.
    - Stopping the down pass with (x) leaves the gear check to the start screen's offer instead of
    starting it; the gear check's summary keeps the step 6 breadcrumb.
    - Demo simulator: the hold-still fallback runs as step 4 and a redo as step 6,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
2026-10-17 App fixes (review round 2): gear-check record, same-origin pages, resume card, iOS 15.0-15.3
    - The gear check only adds its lines to this calibration's record: with no record of its own
    (e.g. its readback came incomplete) it says so instead of overwriting an older calibration's
    gear check; a new calibration forgets the last one's record.
    - Two pages on one origin (the published page and the preview, or two tabs) keep each other's
    saved runs when they write the index.
    - A gear-check append that can't be stored leaves the listed copy as it is stored, and stops
    removing older runs once that can't help.
    - The resume card really is first on the Calibrate start screen (the round-1 CSS rule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
2026-10-17 App fixes (review round 2): reconnect snapshot, checkpoint, stopping the down pass, readbacks
    Link: the drop snapshot (run, firmware level, step 1) is taken when the link drops, not again on
    each failed reconnect; a connect that answers after the timeout is closed; the F,end fallback
    timer is cleared on a drop and a readback still wanted is asked for after reconnecting; K and
    F,end before the first status line use the firmware level from before the drop (isV32/isV33),
    so step 6 starts instead of the v3.2 offer card.
    Flow: a checkpoint answer counts for 3 s or until the link drops (then Continue down / Later
    send again); x or Finish without the down pass ends it with K on this firmware, and t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
2026-10-17 App fixes (tester B, round 2): two drops, lost final K, lost Q,end, stopped down pass
    - Two drops in a row before any status line keep the first drop's snapshot (run, firmware
    level, step 1), so a K / F arriving first is still handled as v3.3.
    - A down pass or redo whose K never reaches the page (lost, or sent while the link was down):
    3 s after the board goes idle the page reads the calibration back and saves it as the run.
    - The down pass ended (not stopped) without its last point: read back as well; after a readback
    the page works with the bridge's points (a later redo is saved from them) and a complete
    down pass marks the flow record done.
    - Q lines whose Q,end was lost: the F li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
2026-10-17 App fixes (tester A, round 2): gear check summary after a redo, drop in step 6, start screen order
    - A Redo from the gear check's summary marks that row 'Redone' and the summary comes back after
    the redo, so a second mismatch can still be redone.
    - A drop during the gear check (or on its summary) leaves focus mode, so the Reconnect card and
    Skip fit; reconnecting brings the check back.
    - With 'Pick up where you stopped' up, the last result card goes below the start screen.
    - review_fixes.js: 2 more checks (58).
2026-10-18 test_v33_app: skip harness scripts that need a positional argument
    E1 runs every bench/tests/app_harness/*.js with no arguments. Scripts whose 'Usage: node ...js'
    header names a required argument (e.g. replay_board_log.js LOG) are tools run by hand on a given
    log: they are reported as SKIP instead of failing. E0 still checks that they parse.
    [test_v33_app.py]
2026-10-18 App: finish card, gear check on the least sure gears, bottom-saved hold, saving-aware wait note
    - After the down pass a 'Calibration done' card offers Check a few gears or Finish and ride
    (to the Ride tab), instead of starting step 6 by itself or showing the start screen. Fixes #9.
    - The gear check starts with the gears the calibration is least sure of (flagged by the bridge's
    check, just redone, or a step clearly smaller than most), the rest from about 5 / 12 / 19; the
    summary marks a redone gear and offers 'Check a few more gears' (matched gears aren't asked
    again; every answer goes into the saved file). Fixes #10.
    - The bottom (point 1), taken moments after the sweep, stays 'Got i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
2026-10-18 App: the gear list at the end of a calibration, with per-gear quality and Improve (#11 phase 1)
    When the down pass is saved, a 'Calibration done' card shows the 24 gears as chips coloured by
    how well their edges were captured: red = flagged by the bridge's check (F lines); yellow = a
    gear much narrower than most, an edge whose up and down readings are far apart, or a point that
    needed two or more hold-still tries (W) or a go-back; green otherwise. Tap a gear for why.
    'Improve N gears' redoes the red, then the yellow edges with the existing guided redo queue
    (#R, best guess, skip), keeping the queue across each redo's F list; then the list comes back
    with 'N of M gears improved'. Check a few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
    [test_v33_app.py]
2026-10-18 App: the Calibrate tab opens on the stored calibration's gear list (#12)
    With a calibrated v3.3 bridge the Calibrate tab shows 'Your calibration': the gear list (#11) for
    the calibration on the bridge, with Improve calibration, Check a few gears and Calibrate again
    (the walkthrough). When the page doesn't have that calibration (after a reload) it reads it back
    quietly with k: nothing saved, no review card; the F list colours the chips.
    Each saved calibration file gets a '# point_stats:' line (hold-still tries and go-backs per
    point); when a readback matches a saved file on this phone (same points to 0.1 uT), those yellow
    reasons come back. Fixes #12.
    review_fixes.js: 6 more checks (81). Buil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
2026-10-18 App fixes (pass 1 of 3: debug agents and test users)
    Saved data and state: a stored-calibration save no longer hides the run's point_stats (#14); a
    redo's own hold-still tries count (stats cleared when the redo starts, not at its capture) (#15);
    a read-back calibration takes only its matching file's stats, or none (#16); the quiet readback
    can't get stuck on a lost F,end (5 s limit) (#17) and stays quiet when Q,end is lost, reading
    again at most twice (#18); the gear check from 'Your calibration' goes to the file that matched
    the readback, never an unrelated one (#19); a run deleted on another page stays deleted (#20).
    Improve: the gear a best guess was for leaves the queue (#21); yellow gea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
2026-10-18 App fixes (pass 1, returning-rider tester) and a cleanup of repeated lines
    - A drop during Improve says 'Connection lost: reconnect to carry on' and the walkthrough stays
    hidden under the card (#38).
    - The gear check after Improve starts with the gears just improved (#39).
    - A gear-check mismatch shows red on the gear list, with what the console showed; redoing that
    gear (or a later match) clears it (#40).
    - 'Keep it as it is' / Skip in Improve: the gear list says so and stops offering that gear (#41).
    - With learnfail, 'learn again' in the simulator goes back to step 2 (as the firmware); in focus
    mode the toast sits below the breadcrumb (#42).
    - 'Your calibration': no empty line above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
2026-10-18 App fixes (pass 2, storage and state): a rejected or stopped calibration, re-reads, retries
    - A new calibration (also one rejected by the bridge, or stopped) makes 'Your calibration' read
    the bridge's calibration again, instead of showing the attempt as the bridge's (#46).
    - A re-read that finds another calibration than the page knew starts clean: no gear-check misses,
    kept gears, improved gears or flags carried over from before (#47).
    - A quiet readback that gets no (complete) answer is tried again later, at most twice more on a
    link (#48).
    - A redo picked up again after a reconnect keeps the hold-still tries it had (#49).
    - Two pages on one origin: listed runs whose data is gone aren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
2026-10-18 App fixes (pass 2, gear list engine): cancelled redos, kept gears, check misses, lost lines
    - A redo that doesn't save (skipped, cancelled, refused) gives back what was known about its
    point (hold-still tries, gear-check miss, kept), so it isn't shown green or 'improved' (#52).
    - A gear kept as it is stays out of the improve queue when the bridge flags it again (#53).
    - A lost quiet F list leaves nothing behind (qJustEnded too), so Improve doesn't stop after the
    first gear (#51).
    - Improve from 'Your calibration' catches up after a lost K (readback, the bridge's copy) (#55).
    - A match later in the same gear check doesn't erase that check's own mismatch (#56).
    - Done after a gear check: t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
2026-10-18 App fixes (pass 2, test user 3): the Calibrate start screen, the gear check summary, double taps
    - Start screen: with something to pick up, the resume card comes first and the walkthrough waits
    behind 'Start a new calibration' (which hides the resume card) (#58); a saved calibration's card
    no longer sits under the walkthrough or the gear list (#25, #45); 'Calibration stopped' comes
    first, without the file name or raw reason (#27); with the Connect card up, the walkthrough's
    picture shrinks so Continue stays above the tab bar (#34).
    - Gear check: 'Stop the gear check' (it ends the step, not one gear) (#59); each mismatch row
    names the change of gear its Redo is for, and once all are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
2026-10-18 App fixes (pass 2, replay and fuzz): readbacks that come back short, cut lines, drops
    - Skip on the last Improve card keeps 'N of M gears improved' (the list isn't opened twice) (#62).
    - The page's own readback that comes back incomplete twice: the page keeps its own points plus
    what the bridge sent, saves that as the run's file (with a note), shows the gear list (gears
    with no reading are unsure, not 'good'), and an Improve pass carries on (#63).
    - A readback is complete only with all 25 points and no gap in the down points (#64).
    - 'Your calibration' stays on screen through a drop and the re-read after it (#65).
    - A K line cut short (fewer than 6 fields) is not a result; a 'save failed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
2026-10-18 App fixes (pass 2, test user 4): buttons that move, a dropped run, v2 walkthrough, learnfail
    - Step buttons stay put: Next / Yes, it matches are pinned to the bottom like CAPTURE, so a
    two-line heading, Paused or the Waiting note no longer pushes them down; the gear check's note
    fits one line ('Keep pedalling: the gear updates each turn') (#44).
    - A drop while calibrating shows 'Calibration paused: reconnect, the bridge has kept your place'
    instead of the first-time walkthrough and an old result card (#69).
    - A v2 bridge's walkthrough shows its own first page (the page cache followed the wrong list) (#68).
    - With the hold-still method (crank not found), the note under the circle says w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
2026-10-18 App fixes (pass 3, engine and storage): unseen redo ends, lost readback ends, another calibration, recovered runs
    - #74 A redo whose end the page didn't see (a link drop, lost E/K/A) is settled by the readback:
    the point changed means saved (no old tries back, Improve goes on); unchanged means not saved.
    A K during a started redo is that redo's K (E,ok,saved lost); E,ok,saved and the okd path
    clear the kept-aside stats; a refused #R no longer gives back the last redo's.
    - #76 The page's own readback: its F list has a 5 s limit (then carry on, or read again).
    - #72 Q lines and then nothing: the page's own readback takes what came after 10 s.
    A gear the bridge saved leaves the Improve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
2026-10-18 App fixes (pass 3, test users): reconnect flash, Calibrate dot, gear list why, wording
    - #77 Until the first status line after a reconnect, the screen stays what it was during the drop
    (the dimmed list, Calibration paused): no walkthrough or saved card flashing up.
    - #78 The Calibrate tab's dot no longer counts a saved v3.3 calibration (the gear list shows it).
    - #43 / #82 A tapped gear's "why" takes the lead's place in a slot of fixed height: the buttons
    stay put (433-589 at 393x660, tab bar at 596).
    - #42 The crank-not-found reasons in plain words; "the sweep is skipped" only on v3.3.
    - #59 The top bar's (x) is labelled "Stop the gear check".
    - #60 The mismatch row says "where gear N s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
2026-10-18 App fixes (pass 3, first-time rider): walkthrough picture, Calibrate again, Later, no down pass
    - #79 With the Connect card above it, the walkthrough's pictures shrink with their box (the dial
    covered the title).
    - #80 Calibrate again opens the walkthrough at page 1; (x) at step 1 goes back to 'Your
    calibration' (Back stays on the walkthrough).
    - #81 After Later the bridge says cal 7 a moment longer: that's no flow step, so no strip shows
    over the resume card and its buttons don't jump.
    - #58 leftover: with the resume card up, the review card waits (no stack-up after Later).
    - #83 Until the down pass is measured the list says so, not "looks good going up and coming down".
    - #42 At the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
2026-10-18 App fixes (pass 3, replay and fuzz): cut F and U lines, first open, a given-up readback's F list
    - #84 A flag line cut short (fewer than 7 fields, or no reason) is not a flag; the F,end timer
    finishes the list. A cut down-pass undo (U,n without ,d) during the down pass is ignored.
    - #85 A fresh page on a calibrated bridge shows "Your calibration / Reading it from the bridge"
    while it reads, not the first-time walkthrough.
    - #86 The readback that gave up gets the same 5 s limit for its F list: the gear list opens.
    review_fixes.js: 3 new checks (117 in all).
2026-10-18 Firmware v3.4: press to capture (#5); no N,stuck, soft-hold guard, one go-back per point (#6, #8)
    - '#A,press' / '#A,auto' (E,ok,capture,<mode>), flags T (press mode) and I (measuring);
    a press (n, button A, the page's circle) answers N,press and measures the next turns
    (2 agreeing + the check turn); a refused press (N,notmoved) is saved by a second press
    unless it is within 0.4 uT of the previous point
    - '#V' -> E,ok,v3.4; S lines keep 16 fields; auto stays the power-up default, so the
    page in use today is unaffected
    - N,stuck removed (fired after most captures on the 2026-10-17 bike run)
    - soft hold (new spot, auto mode) needs max(noise floor, 0.12 x step) and 8 still turns:
    no m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
    [fw_model.py, riders.py, test_v33_sim.py, test_v33_unit.py, test_v34_press.py]
2026-10-24 v3.4 on the board: all 6 board-in-the-loop scenarios match, two of them in press mode
    - scenarios P1_press (presses at every point) and P5_press_refused (60 s rests, a refused
    press then a second press) recorded from the model and replayed on the board
    - hil_board_all: each scenario starts erased AND in auto mode ('#A,auto'): the capture mode
    survives '#E', so a press scenario left the v3.2b ride waiting for presses
    - backup of the board's 10-17 calibration before the tests (restored afterwards with #P/#W)
2026-10-24 App: press to capture with firmware v3.4 (#5): the circle is the button
    - Each connection asks the firmware version (#V). A v3.4 bridge is set to the rider's capture
    mode (#A,press by default, or #A,auto), kept on this phone (m3bridge.capture). Older bridges
    answer E,fail, which is taken quietly; they save each gear by themselves as before.
    - In press mode (flag T) the circle is the button on the up pass, the down pass and redos:
    a blue edge and "Tap to save"; a tap sends n and shows "Measuring..." (flag I) until the
    point is saved. A tap during "Got it" counts for the next gear.
    - N,notmoved after a tap: the note says the turns sat where the gear before was saved, and that
    a secon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
2026-10-25 Phone export of the first v3.4 press-mode bike calibration (2026-10-25)
    [2026-10-25_v3_4_cal_phone.csv]
2026-10-25 Bluetooth burst bench test (#91): pieces dropped by the board, reproduced from a PC
2026-10-25 App: calmer redo screen, redo any gear from the list, lost-line re-reads, walkthrough to match
    From the rider's first press-mode bike run (2026-10-25):
    - #88 The redo screen goes step by step: no explanation box, no step bars or cadence bar during
    a redo ("Redo gear 20", "Shift down into gear 19 / Then back up to 20", "step 1 of 2").
    The hold-still strip and the amber boxes are gone; the one note that matters takes the
    count's place under the circle in a fixed-height line, so the circle never resizes.
    The circle's label is centred over its number (it sat left over two-digit numbers).
    - #90 Tap any gear on the list (green too) and the main button reads "Redo gear N": it redoes
    where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
2026-10-25 Firmware v3.4.1: Bluetooth lines whole or not at all (#91, #92)
    - DualLog::sendLocked retries a piece the link can't take yet instead of dropping it:
    S/X lines get one try and are skipped whole when the link is behind; other lines wait
    up to 3 s for the first piece and 1 s for each further piece; a disconnect ends it
    - 'p' reports lines skipped / cut short since power-up; '#V' still E,ok,v3.4 (the page
    accepts only E,ok,v3.<n>); banner v3.4.1
    - bench (PC over BLE): readback 49/49 intact, 0 glued (was 1/49)
    - PROTOCOL.md: Bluetooth delivery note; backup of v3.4 before the change
2026-10-25 Firmware v3.5: whole-gear redo by taps (#87); Bluetooth mailbox (#91, #92)
    - '#R,g,<gear>': tap in the gear below, where the gear first shows going up, in the gear
    above, where it first shows coming down; pass g1-g4, step = gear-1, flag I while measuring,
    no flag B; both points saved together (one E,ok,saved / K / F list); gear 1 only g3-g4,
    gears 23-24 only g1-g2; x cancels with nothing changed; u cancels a tap, else back a stage.
    References are judged along the up points (the riding path sits half a gear lower).
    - Bluetooth: status keeps only the newest line; every other line is queued whole and sent by
    its own task, so the loop never waits on the phone and nothing arrives half-s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
2026-10-25 PROTOCOL v3.5 additions (#R,g gear redo, Bluetooth mailbox, #H) and the hand-off to the app chat
2026-10-25 v3.5 on the board: all 7 board-in-the-loop scenarios match, incl. the gear redo by taps
    The board was erased afterwards (Q,none): no test calibration left on it.
2026-10-25 App: redo a gear by taps with firmware v3.5 (#87); the bridge's text only in the Console
    - On a v3.5 bridge every redo is #R,g (Improve, a gear tapped on the list, the gear check's
    Redo), by taps in any capture mode. The circle walks the stages: DOWN TO g-1, UP TO g,
    UP TO g+1, BACK TO g ("step k of 4"; gear 1 has stages 3-4, gears 23 and 24 stages 1-2).
    A tap in the wrong gear (N,notmoved) gets "Not in gear N yet". "Got it" between stages.
    - Its C / C,down lines are held until E,ok,saved (or the K): a cancel leaves the phone's copy
    as the bridge's. U during g1-g4 is a stage back, not an undo of points.
    - The kept-aside point stats cover both points of the gear; Improve drops both fr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
2026-10-27 App: the circle keeps its size in the down pass; a result after each redo; real buttons
    From the rider's notes (2026-10-27):
    - The circle shrank in the down pass. On the 10-25 ride (build 10-24.1) the "Waiting for your tap"
    note took 90 px from it after 10 s at a gear, on top of the down pass's button; notes stopped
    taking room in #88. Now also: "Finish without the down pass" sits in the line under the circle,
    press mode gets the CAPTURE row back (270 px on both passes at 393x660; auto: 220 / 176), and the
    size follows the steady screen height (svh), not one that changes as the browser's bars move.
    - After each Improve redo: a gear that came out good gets "Gear N looks good now ✓"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
